ytmytm/ESPsette/kicad/production/bom.csv

Designator | Footprint | Quantity | Value | LCSC Part #
BUT_RESET1 | SW_PUSH_6mm | 1 | BUT_RESET
C1 | CP_Radial_D8.0mm_P3.50mm | 1 | 100µF
C6, C7 | CP_EIA-3216-12_Kemet-S_HandSolder | 2 | 10µ | C1969735
J1 | C64-Cassette-Port-Female | 1 | C64_TAPE_PORT
J2 | Mini_DIN_round_7_canned | 1 | Mini-DIN-7
J3 | PinHeader_1x06_P2.54mm_Vertical | 1 | UART
J4 | PinHeader_1x03_P2.54mm_Vertical | 1 | AMS1117
J5 | PinHeader_1x02_P2.54mm_Vertical | 1 | EXT.POWER
JP1, JP2, JP3, JP4, JP5 | SolderJumper-2_P1.3mm_Bridged_RoundedPad1.0x1.5mm | 5 | Jumper_2_Bridged
JP_FLASH1 | PinHeader_1x02_P2.54mm_Vertical | 1 | JP_FLASH
R1 | R_Axial_DIN0207_L6.3mm_D2.5mm_P7.62mm_Horizontal | 1 | 470R
R2, R3, R4, R5 | R_Axial_DIN0207_L6.3mm_D2.5mm_P7.62mm_Horizontal | 4 | 10K
R6 | R_Axial_DIN0207_L6.3mm_D2.5mm_P7.62mm_Horizontal | 1 | 1K
U1 | ESP-01 | 1 | ESP-01v090
U2 | DIP-6_W7.62mm | 1 | 4N35
U3 | SOT-223-3_TabPin2 | 1 | AMS1117-3.3 | C6186
