ytmytm/ESPsette/experiments/fastloader/BOOTSTRAP.md

# Standard-ROM bootstrap and autostart

Three stages take an ordinary ROM `LOAD` through to PRG execution. Native
sources are in `native/fastloader/`; `make native` builds both targets with ACME.

| Component | C64 | C16 / Plus/4 |
| --- | --- | --- |
| Autostart vector, standard data block | `$0302..$0303` | `$0302..$0303` |
| Code inside standard header tail | `$0351`, 163 B | `$0348`, 157 B |
| Full receiver | `$0400`, 482 B; send 512 B | `$0800`, 610 B; send 768 B |
| Final ROM handoff trampoline | `$033C` | `$0333` |
| Firmware PRG address range | `$0801..$CFFF` | `$1001..$FCFF` |

The combined C16/Plus4 profile targets C16 with 64 KB RAM and Plus/4.
Programs through `$FCFF` are supported; writes beneath TED BASIC/KERNAL ROM
reach RAM without changing the mapping, as on C64. `$FD00` starts I/O.
Small programs remain usable on a stock 16 KB C16.
C64 writes beneath BASIC ROM reach RAM without changing the memory mapping;
the receiver keeps ROM/I/O visible and stops before `$D000`. A program that
needs to read that RAM later must select its own memory mapping. Payloads
overlapping the loader or reaching I/O are not supported.

## Standard tape stage

`PrgEncoder::beginAutostart()` generates a type-3 absolute header for a two-byte
load at `$0302`. The vector targets code in the unused header tail, after the
filename. C64 has 16 filename bytes and 171 code bytes. TED stores the type
byte separately at `$F8` and prints 17 filename bytes (ROM `$E9F3..$E9FD`,
Y=4..20 inclusive). Its seventeenth display byte is padded with a space;
code begins at tape offset 22 / RAM `$0348`, with 170 bytes available.
Putting code at offset 21 / `$0347` would print its first opcode as a stray
character after the name.

The production encoder generates both copies, parity and checksums, using its
ordinary pilot lengths. Two hundred short tail pulses allow the ROM to finish
the second data copy. The vector bytes are independent of the streamed PRG;
the PRG ring remains retained at offset 2 until the GPIO payload stage.

C64 starts with `SEI`, `LDA #$27`, `STA $00`, making WRITE input after seven
CPU cycles. TED first writes zero to the port latch and sets DDR `$0B`:
P1 must stay output low to release the external inverting 7406 sink. Setting
P1 to input leaves that driver sinking the physical line. Physical WRITE
returns through P6, shared with IEC CLK. The bootstrap then blanks the screen;
C64 additionally disables sprites and CIA interrupt sources.

## Mode selection

The stub temporarily makes WRITE an output and sends the physical word `$CA65`,
MSB first, sampled by ESP on each MOTOR-on transition. Each MOTOR-off interval
exceeds 1 ms even at fast TED NTSC speed. An additional MOTOR-on interval
separates bits. The external 7406 output inversion is accounted for in the stub.

The ESP keeps WRITE input throughout selection. Upon the `110` signature
prefix, its MOTOR ISR stops the I2S transmitter and switches READ high to GPIO,
well before the stub clears stale FLAG events. DMA allocation cleanup occurs
later in loop, not in the ISR. This prevents queued standard pulses or the idle
level from creating a false first fast strobe. The complete `$CA65` word arms
the receiver download. The final MOTOR-on is not itself a block request.

Immediately after the final signature bit, the computer releases WRITE again,
without the usual final MOTOR-on delay, and requests the first receiver page
by changing MOTOR. ESP starts driving data only after that request and its
settling delay. C64 keeps WRITE input throughout both downloads; TED keeps P1 output low
and reads physical WRITE on P6.
The full bootstrap receiver never repeats the cold monitor test's WRITE-output
initialization.

## Receiver download

The small stub uses simple MSB-first pairs: b7:b6, b5:b4, b3:b2, b1:b0.
It requests whole 256-byte pages with no descriptor; address and page count
are assembled into the stub. Default hold and byte pause are both 80 µs;
setup and pair gap are each 3 µs. All are configurable in the ESP settings.
After the last page, the sender changes to the optimized descriptor/payload
protocol in [README.md](README.md).

C64 uses screen RAM for the full receiver. TED uses color RAM: `$0400` contains
executable BASIC helpers and system state which must survive for RUN. The
receiver normalizes MOTOR to on before requesting its descriptor with off;
the sender ignores that normalization edge after the last bootstrap page.
A request arriving during the final pair hold remains pending.

## Payload and handoff

The descriptor contains destination, length and entry as little-endian words.
The optimized receiver reads up to 256 bytes per MOTOR transition. It owns
`$F7..$FF` and the stack. Pair assembly is inline, Y indexes the destination
and counts bytes, and only page rollover increments the pointer high byte.

Once the payload is stored, the receiver copies a small handoff trampoline
into the now-unused tape buffer. It restores ports/timers, KERNAL and BASIC
vectors, initializes the screen, restores program bounds, clears cassette
status and keyboard input, and launches the program. Screen initialization
may overwrite the receiver without overwriting the trampoline. Entry zero
selects BASIC CLR/RUN; any other entry selects JMP with IRQs enabled.
The ESP releases WRITE/SENSE after the final data hold before ROM resumes.

The harness exports ordinary periods and a TAP for stage one. That TAP alone
cannot load the PRG: the complete sender must recognize the signature and
supply the two fast stages. TED's ordinary pulses begin LOW, with LOW/HIGH
halves belonging to the same period. Starting at the other phase would pair
adjacent pulse lengths and prevent the ROM from recognizing the header.

## Reproducing the complete load

```sh
python3 experiments/fastloader/run-bootstrap-vice.py --machine all
python3 experiments/fastloader/run-bootstrap-vice.py --machine all --ntsc --mode machine
python3 experiments/fastloader/run-bootstrap-matrix.py
```

Monitor commands only type LOAD and observe execution/memory. ROM device-1
traps are disabled. Tests compare every downloaded receiver/payload byte and
confirm BASIC POKE or machine-code marker execution after ROM restoration.
The regression matrix covers three machines, both video standards, both launch
paths, block/page boundaries, unaligned destinations, maximum RAM payloads and
both C64 CIA variants. The ESP GPIO implementation and configurable delays also
have host wire-order tests. C64 PAL fastloading was confirmed on real hardware
on 2026-11-04; the user confirmed C16 hardware operation on 2026-11-11.
Remaining hardware variants still need testing.

There is no payload CRC or automatic retransmission. STOP releases the ESP
outputs; reset the computer before retrying an interrupted receiver. The
current ROM entry points target stock C64 BASIC and TED BASIC 3.5.

## C16 electrical regression (2026-11-11)

The local LittleSixteen schematic/netlist (`datasette.sch`, revision 4git,
2024-08-11) shows cassette WRITE through FB17 and R29 (100 ohms) into P6,
also the IEC CLK input. P1 controls IEC CLK through the inverting open-collector
U9 7406. READ goes to P4; MOTOR uses P3 through U9/Q5. With default JP12 1-2,
SENSE goes to the `$FD10` bit-2 path; JP12 2-3 reroutes it to P7 and is not the
loader's supported configuration. A 6510 conversion with permanently enabled
MOTOR is also outside this protocol, which requires MOTOR block requests.

The previous VICE model injected WRITE directly into P1 and omitted the
7406 sink, allowing a loader that could not work on this wiring to pass.
The isolated patch now combines physical WRITE, the IEC CLK level and the
computer's sink at P6. Against that model the old bootstrap detects CA65 but
fails to download the receiver; the corrected bootstrap and payload receiver
both read P6 and release the sink using P1 output low. The payload receiver
uses the final READ poll's BIT overflow flag to sample P6 without an extra
port read; the timing analyzer covers the slower WRITE-high branch.

The user confirmed that the corrected C16 fastloader works on real hardware
on 2026-11-11. VICE regression results: 33/33 complete bootstrap checks and
39/39 transport checks, including expected failures with unsafe timings.

## TED filename and 64 KB range regression

The ROM display test now stops after the FOUND filename loop and compares all
17 displayed bytes, including the trailing space. PAL/NTSC long-name cases and
maximum payloads through `$FCFF` pass for both BASIC RUN and machine-code
handoff. The expanded bootstrap matrix passes 38/38 checks.

Original local Aardvark (12,287 payload bytes, SYS 9458), Acidball (25,557 bytes,
SYS 4114) and AFL_Boulderdash (31,518 bytes, SYS 4128) each pass cold C16/64-KB
PAL ROM loading, full receiver/payload comparison and the BASIC SYS breakpoint.
Boulderdash's payload ends at `$8B1F` exclusive, exercising RAM beneath ROM.
Local game binaries are not included in the repository.

The user confirmed the filename and larger-PRG fixes work on hardware on
2026-11-11.
