ytmytm/ESPsette/kicad/plots/espsette.pdf

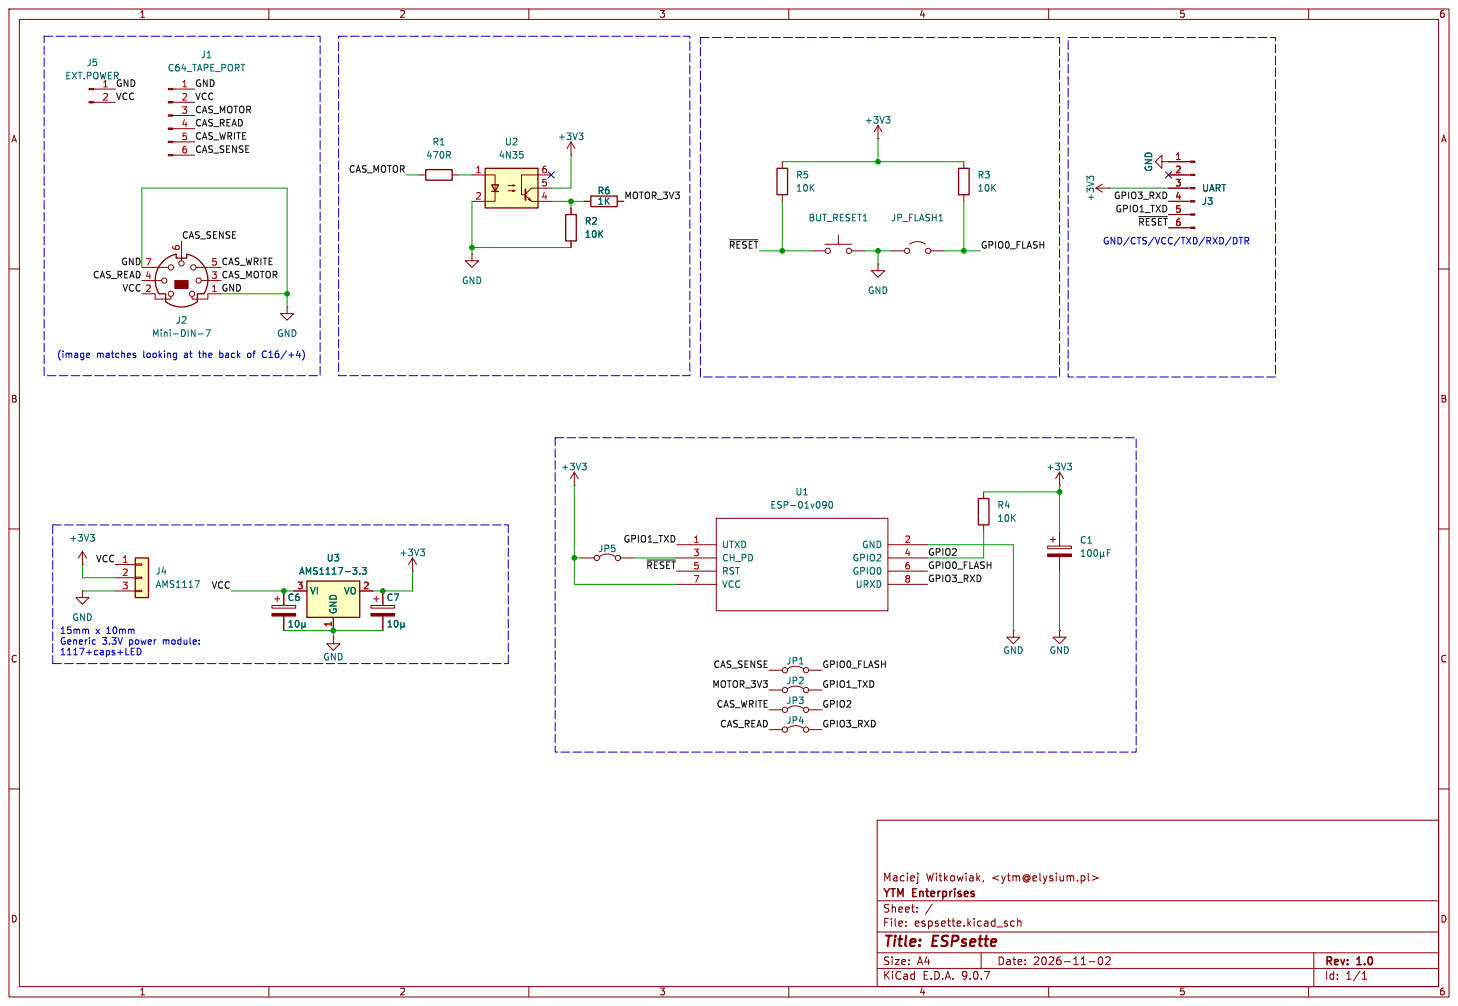
[picture p4: page 1]

þÿ10µ GND GND
Generic 3.3V power module: 1117+caps+LED
