ytmytm/ESPsette/(list of files, drawings)

Other design files:
kicad/espsette.dsn
