ytmytm/ESPsette/kicad/espsette.kicad_pcb

## KiCad design kicad/espsette.kicad_pcb (2026-11-11)

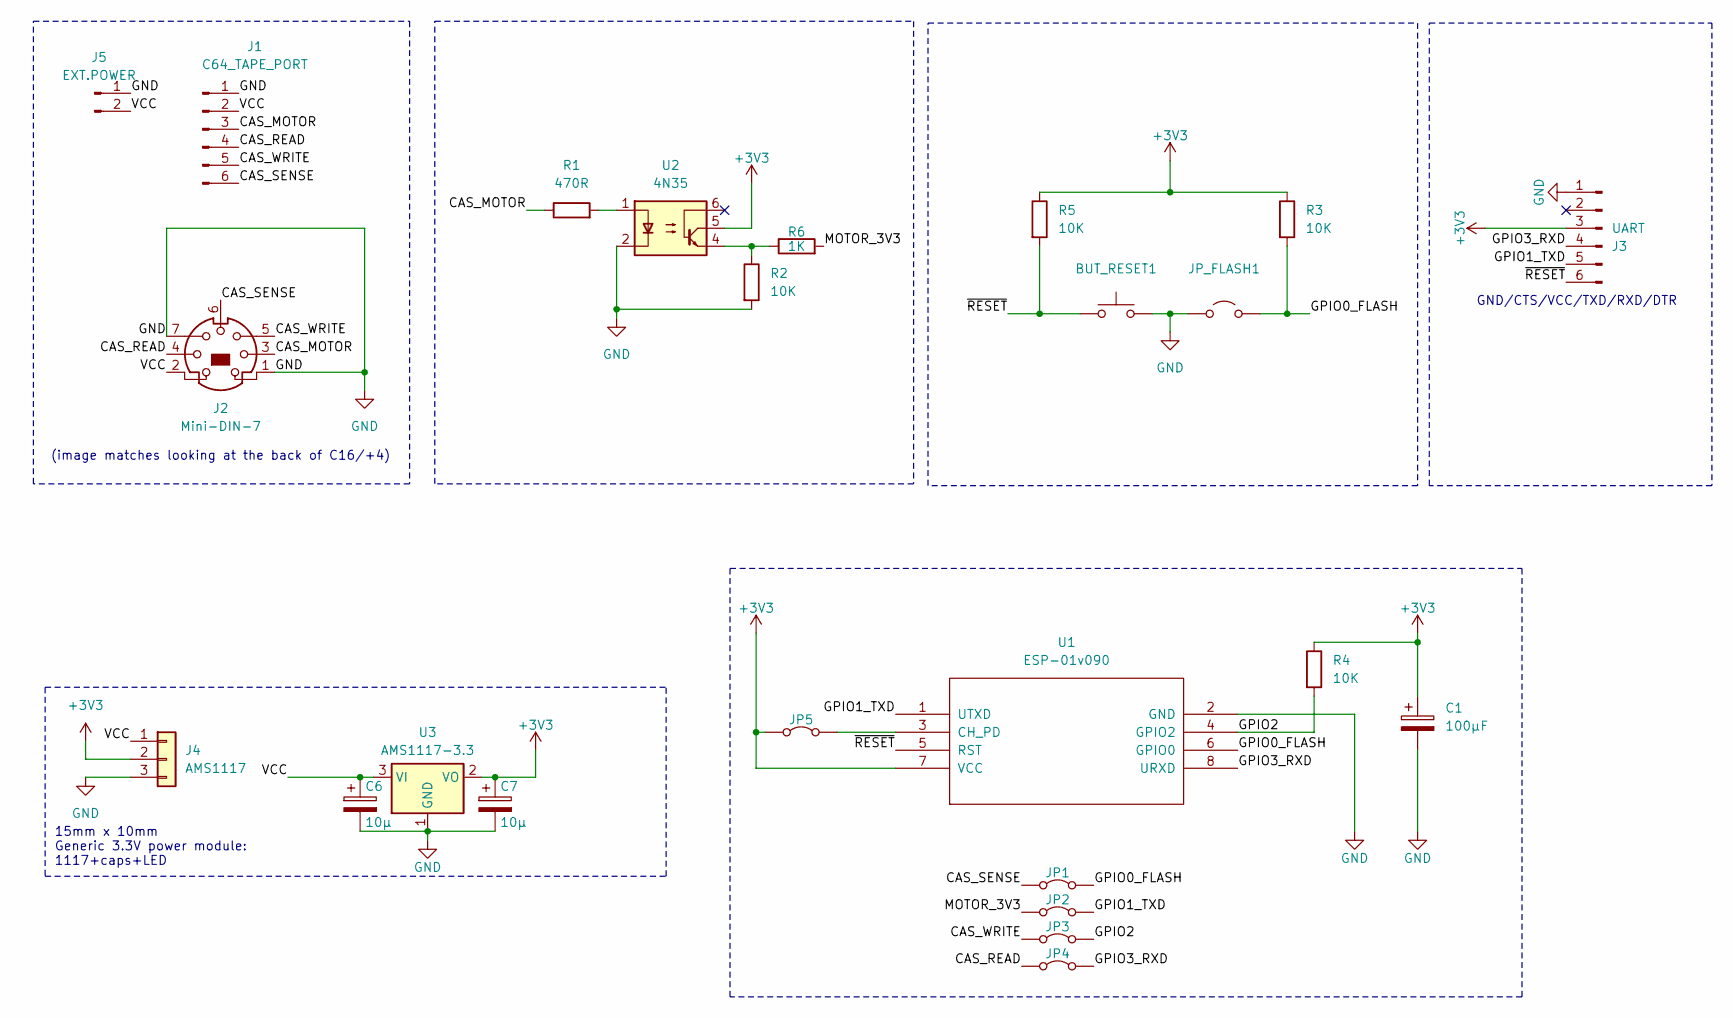
[picture p5: schematic espsette.kicad_sch]

Parts:
BUT_RESET1: BUT_RESET; SW_PUSH_6mm
C1: 100µF; CP_Radial_D8.0mm_P3.50mm
C6, C7: 10µ; CP_EIA-3216-12_Kemet-S_HandSolder; JLCPCB Part # C1969735
J1: C64_TAPE_PORT; C64-Cassette-Port-Female
J2: Mini-DIN-7; Mini_DIN_round_7_canned
J3: UART; PinHeader_1x06_P2.54mm_Vertical
J4: AMS1117; PinHeader_1x03_P2.54mm_Vertical
J5: EXT.POWER; PinHeader_1x02_P2.54mm_Vertical
JP1, JP2, JP3, JP4, JP5: Jumper_2_Bridged; SolderJumper-2_P1.3mm_Bridged_RoundedPad1.0x1.5mm
JP_FLASH1: JP_FLASH; PinHeader_1x02_P2.54mm_Vertical
R1: 470R; R_Axial_DIN0207_L6.3mm_D2.5mm_P7.62mm_Horizontal
R2, R3, R4, R5: 10K; R_Axial_DIN0207_L6.3mm_D2.5mm_P7.62mm_Horizontal
R6: 1K; R_Axial_DIN0207_L6.3mm_D2.5mm_P7.62mm_Horizontal
U1: ESP-01v090; ESP-01
U2: 4N35; DIP-6_W7.62mm
U3: AMS1117-3.3; SOT-223-3_TabPin2; JLCPCB Part # C6186

Connections:
+3V3: C1.1, C7.1, J3.3, J4.2, JP5.2 (B), R3.1, R4.1, R5.1, U1.7 (VCC), U2.5, U3.2 (VO)
/CAS_MOTOR: J1.3, J2.3, R1.1
/CAS_READ: J1.4, J2.4, JP4.2 (B)
/CAS_SENSE: J1.6, J2.6, JP1.2 (B)
/CAS_WRITE: J1.5, J2.5, JP3.2 (B)
/GPIO0_FLASH: JP1.1 (A), JP_FLASH1.2 (B), R3.2, U1.6 (GPIO0)
/GPIO1_TXD: J3.5, JP2.1 (A), U1.1 (UTXD)
/GPIO2: JP3.1 (A), R4.2, U1.4 (GPIO2)
/GPIO3_RXD: J3.4, JP4.1 (A), U1.8 (URXD)
/MOTOR_3V3: JP2.2 (B), R6.2
/VCC: C6.1, J1.2, J2.2, J4.1, J5.2, U3.3 (VI)
/~RESET: BUT_RESET1.1, J3.6, R5.2, U1.5 (RST)
GND: BUT_RESET1.2, C1.2, C6.2, C7.2, J1.1, J2.1, J2.7, J3.1, J4.3, J5.1, JP_FLASH1.1 (A), R2.2, U1.2 (GND), U2.2, U3.1 (GND)
unnamed: JP5.1 (A), U1.3 (CH_PD)
unnamed: R1.2, U2.1
unnamed: R2.1, R6.1, U2.4

Notes on the sheet:
GND/CTS/VCC/TXD/RXD/DTR
(image matches looking at the back of C16/+4)
15mm x 10mm Generic 3.3V power module: 1117+caps+LED

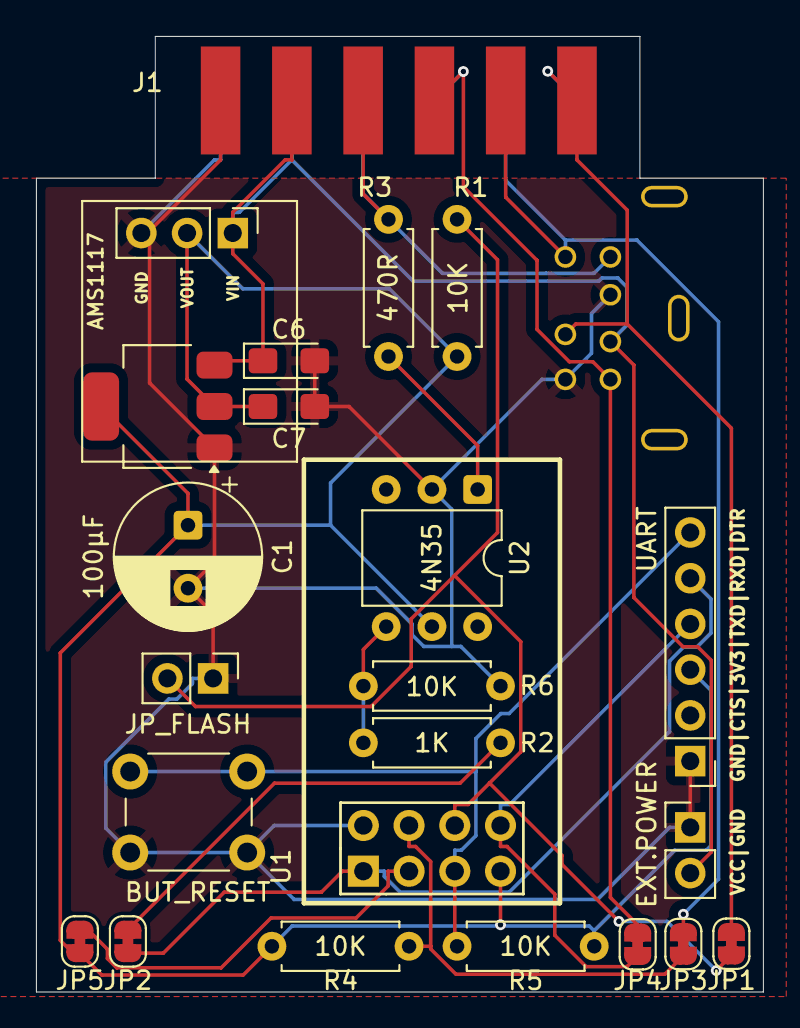
[picture p6: board espsette.kicad_pcb from above]

Board: 2 copper layers, 40.4 x 53.1 mm, 24 parts (0 on the bottom side), 16 nets.
