ytmytm/ESPsette/src/tape_source.cpp

#include "tape_source.h"

#include <pgmspace.h>
#include <string.h>

namespace {
uint8_t flashByte(const uint8_t* address) {
  return pgm_read_byte(address);
}
}  // namespace

void TapeSource::useEmbedded(const uint8_t* data, uint32_t size) {
  kind_ = Kind::EMBEDDED;
  embedded_ = data;
  embeddedRepeat_ = 0;
  prefixSize_ = 20;
  size_ = size;
  retainedFrom_ = 20;
  nextOffset_ = size;
  sessionId_ = 0;
}

bool TapeSource::useEmbeddedPrg(const uint8_t* data, uint32_t size, bool repeat) {
  if (!data || size < 3 || size > 65537) return false;
  useEmbedded(data, size);
  prefixSize_ = 2;
  retainedFrom_ = 2;
  if (repeat) {
    embeddedRepeat_ = size - 2;
    size_ += embeddedRepeat_;
    nextOffset_ = size_;
  }
  return true;
}

void TapeSource::useStream(const uint8_t header[20], uint32_t size, uint32_t id) {
  kind_ = Kind::STREAMED;
  embedded_ = nullptr;
  embeddedRepeat_ = 0;
  prefixSize_ = 20;
  memcpy(header_, header, sizeof(header_));
  size_ = size;
  retainedFrom_ = 20;
  nextOffset_ = 20;
  sessionId_ = id;
}

void TapeSource::usePrg(const uint8_t loadAddress[2], uint32_t logicalSize, uint32_t id) {
  kind_ = Kind::STREAMED;
  embedded_ = nullptr;
  embeddedRepeat_ = 0;
  prefixSize_ = 2;
  memcpy(header_, loadAddress, 2);
  size_ = logicalSize;
  retainedFrom_ = 2;
  nextOffset_ = 2;
  sessionId_ = id;
}

bool TapeSource::seek(uint32_t offset, uint32_t newId) {
  if (kind_ != Kind::STREAMED || offset < prefixSize_ || offset >= size_ || newId == 0) return false;
  retainedFrom_ = offset;
  nextOffset_ = offset;
  sessionId_ = newId;
  return true;
}

void TapeSource::eject() {
  kind_ = Kind::EMPTY;
  embedded_ = nullptr;
  embeddedRepeat_ = 0;
  prefixSize_ = 20;
  size_ = 0;
  retainedFrom_ = 20;
  nextOffset_ = 20;
  sessionId_ = 0;
}

bool TapeSource::read(uint32_t offset, uint8_t& value) const {
  if (offset >= size_) return false;
  if (kind_ == Kind::EMBEDDED) {
    if (embeddedRepeat_ && offset >= embeddedRepeat_ + 2) offset -= embeddedRepeat_;
    value = flashByte(embedded_ + offset);
    return true;
  }
  if (kind_ != Kind::STREAMED) return false;
  if (offset < prefixSize_) {
    value = header_[offset];
    return true;
  }
  if (offset < retainedFrom_ || offset >= nextOffset_) return false;
  value = buffer_[offset % BUFFER_SIZE];
  return true;
}

uint16_t TapeSource::bufferedBytes() const {
  return kind_ == Kind::STREAMED ? nextOffset_ - retainedFrom_ : 0;
}

uint16_t TapeSource::freeBytes() const {
  return kind_ == Kind::STREAMED ? BUFFER_SIZE - bufferedBytes() : 0;
}

bool TapeSource::append(uint32_t offset, const uint8_t* data, size_t length) {
  if (kind_ != Kind::STREAMED || offset != nextOffset_ ||
      length > freeBytes() || length > size_ - nextOffset_) return false;
  for (size_t i = 0; i < length; ++i) buffer_[(nextOffset_ + i) % BUFFER_SIZE] = data[i];
  nextOffset_ += length;
  return true;
}

void TapeSource::releaseBefore(uint32_t offset) {
  if (kind_ != Kind::STREAMED) return;
  if (offset > nextOffset_) offset = nextOffset_;
  if (offset > retainedFrom_) retainedFrom_ = offset;
}
