ytmytm/ESPsette/src/write_decoder.h

#pragma once

#include <stddef.h>
#include <stdint.h>

#if defined(ESP8266)
#include <Arduino.h>
#define WRITE_IRAM IRAM_ATTR
#else
#define WRITE_IRAM
#endif

// C64/C16 standard WRITE-header command channel. File data is discarded.
// A verified ESP:<request> publishes a request; command handlers are not installed.
// feedEdgeMicros() accepts same-polarity periods from the direct WRITE pin.
// A pilot selects C64 rising or TED falling edges before byte decoding.
class WriteDecoder {
 public:
  enum class Machine : uint8_t { UNKNOWN, C64, C16 };
  void WRITE_IRAM motorStart(uint32_t quietMicros = UINT32_MAX);
  void WRITE_IRAM motorStop();
  void WRITE_IRAM suspend();
  void WRITE_IRAM feedMicros(uint16_t duration);
  void WRITE_IRAM feedEdgeMicros(uint16_t duration, bool high);
  void WRITE_IRAM overflow();
  Machine machine() const { return machine_; }
  const char* status() const { return status_; }
  const char* name() const { return name_; }
  const char* command() const { return command_; }
  uint32_t commandCount() const { return commandCount_; }
  const char* machineName() const {
    return machine_ == Machine::C64 ? "c64" : machine_ == Machine::C16 ? "c16" : "unknown";
  }
  uint8_t fileType() const { return header_[0]; }
  uint16_t startAddress() const { return header_[1] | (uint16_t(header_[2]) << 8); }
  uint16_t endAddress() const { return header_[3] | (uint16_t(header_[4]) << 8); }
  uint32_t receivedCount() const { return receivedCount_; }
  uint32_t errorCount() const { return errorCount_; }
  uint32_t overflowCount() const { return overflowCount_; }

 private:
  enum class Pulse : uint8_t { INVALID, SHORT, MEDIUM, LONG };
  enum class Stage : uint8_t {
    SEARCH, FIRST_SYNC, FIRST_HEADER, FIRST_CHECKSUM, FIRST_END,
    SECOND_SYNC, SECOND_HEADER, SECOND_CHECKSUM, DISCARD, DONE
  };
  static constexpr uint16_t HEADER_BYTES = 192;
  Pulse firstPulse_ = Pulse::INVALID;
  bool byteBits_ = false;
  bool ambiguousEnd_ = false;
  uint8_t bitIndex_ = 0;
  uint8_t byte_ = 0;
  uint8_t parity_ = 1;
  Stage stage_ = Stage::SEARCH;
  Machine machine_ = Machine::UNKNOWN;
  uint8_t c64Pilot_ = 0, tedPilot_ = 0;
  uint32_t discardBytes_ = 0;
  uint8_t expectedSync_ = 0;
  uint16_t headerIndex_ = 0;
  uint8_t checksum_ = 0;
  uint8_t header_[HEADER_BYTES] = {};
  char name_[17] = {};
  char command_[13] = {};
  uint32_t commandCount_ = 0;
  bool suspended_ = false;
  const char* status_ = "idle";
  uint32_t receivedCount_ = 0;
  uint32_t errorCount_ = 0;
  uint32_t overflowCount_ = 0;

  Pulse WRITE_IRAM classify(uint16_t duration) const;
  void WRITE_IRAM resetFrame();
  void WRITE_IRAM fail(const char* reason);
  void WRITE_IRAM onByte(uint8_t value);
  void WRITE_IRAM onTerminator();
  void WRITE_IRAM finishHeader();
};
