ytmytm/ESPsette/(commit log)

2026-10-22 Add KiCad project and output directories
2026-10-22 Document hardware activity LEDs
2026-10-23 Keep PlatformIO state local for NFS and add VERBOSE builds.
    flock fails on the share; route core/cache/workspace under ~/.cache and print progress before pio starts.
2026-10-23 Disable RemoteDebug WebSockets for ESP8266 Arduino 3.x.
    Bundled WebSockets calls removed BearSSL verify(); Telnet debug is enough, with a small patch as a safety net.
2026-10-23 Fix web handler prototypes and IRAM interrupt attrs.
    PlatformIO needs forward decls for handleRoot/handleNotFound; replace deprecated ICACHE_RAM_ATTR.
2026-10-23 Treat firmware as a normal C++ translation unit.
    Add Arduino.h so PlatformIO skips .ino preprocessing after the rename.
    [main.cpp]
2026-10-24 Document CH340 DTR-to-RST flash wiring and esptool reset.
    Verified GPIO0-GND plus DTR-RST on a wemos.cc adapter; esptool.cfg pulses DTR only.
    [esptool.cfg]
2026-10-24 Add make help listing build and serial flash targets.
    Default make goal so bare make shows usage and CH340 wiring notes.
2026-10-24 Add a small UART dump helper for ESP8266 ROM boot messages.
    Pulse DTR like esptool.cfg hard reset and capture 74880 baud output for reboot-loop checks on USB-serial.
    [esp_boot_dump.py]
2026-10-24 Document repeated PRG data requirement for streaming encoder
2026-10-24 Add failure vectors, session recovery, and runtime diagnostics
    [main.cpp, write_decoder_test.cpp]
2026-10-24 Replace deprecated ICACHE_RAM_ATTR with IRAM_ATTR.
    Carry the bootstrap interrupt-attr cleanup onto the rebased implementation tree.
    [main.cpp]
2026-10-24 Add forward declarations for HTTP handlers in main.cpp.
    PlatformIO no longer auto-prototypes after the .ino to .cpp rename.
    [main.cpp]
2026-10-24 Add ESPSETTE_GPIO_DISABLED bench mode for Wi-Fi-only bring-up.
    Keep tape MOTOR/SENSE/READ off the pins by default so USB-serial bench can run AP and the web UI without remapping UART or driving cassette GPIOs.
2026-10-24 Restore flash wiring docs and add cassette pin table.
    Bring back the CH340 DTR–RST ESP-01 flash guide lost in the implementation rebase, and document MOTOR/SENSE/READ/WRITE GPIO mapping next to the soft-GPIO bench note.
2026-10-25 Defer PROGMEM demo insert so Wi-Fi survives boot and /demo.
    Walk the embedded TAP only from loop via pgm_read_byte, and poll /state until load finishes instead of blocking the HTTP handler.
2026-10-25 Replace the custom Wi-Fi portal with WiFiManager captive setup.
    Match ESPHome-style AP provisioning, wipe legacy LittleFS config once, and re-enter setup via /wifi.
    [network_config.cpp, network_config.h]
2026-10-25 Add soft playback, READ scope, and server FF for GPIO-disabled bench.
    Treat motor as running without I2S so the deck and counter animate, expose a downsampled READ waveform, allow /nav seeks on embedded TAP, and scroll to the deck after Demo tape.
2026-10-25 Require PLAY with motor for tape run; polish deck and IDX nav.
    Gate soft/real playback on MOTOR+PLAY, lock reel positions, show demo ROM buffer and remaining time, and make REW/FF follow IDX markers or tape ends.
2026-10-25 Enable open OTA and document the 1m64 flash trade-off.
    Use a 64KB LittleFS layout so ArduinoOTA fits on 1MB; keep TAP streaming from the browser because there is no room for a LittleFS tape cache. /wifi only forgets Wi-Fi after confirm.
2026-10-25 Disable OTA while the embedded demo keeps the 1MB image oversized.
    ArduinoOTA needs a second copy of the sketch; with draxcaught in PROGMEM that fails with Not Enough Space, so ESPSETTE_OTA=0 and updates stay on serial flash.
    [main.cpp]
2026-10-25 Document boot-safe 4N35 MOTOR wiring for the KiCad netlist.
    Capture the open-collector pin4/pin5 swap with pull-up so GPIO0 stays high at C64-powered cold start, and note that SENSE/autoplay cannot fix that boot strap.
2026-10-25 Fix soft TAP underrun by releasing the stream ring, and show C64/C16.
    GPIO-disabled playback never freed consumed bytes, so the 8 KB buffer stalled after one fill; also surface the TAP header machine on the deck.
    [main.cpp, tape_source_ring_test.cpp]
2026-10-25 Enable real cassette GPIOs in the default 1MB build.
    Switch ESPSETTE_GPIO_DISABLED off for hardware LOAD testing; soft-GPIO remains available via the build flag.
2026-11-01 Clarify build, serial flash wiring and hardware test status
2026-11-01 Document both tape connector options and ignore local TODO
2026-11-01 Record complete C64 tape connector CAD reference
2026-11-01 Document PCB edge contacts as a tape connector fallback
2026-11-01 Specify ESP-01 power, reset and in-circuit programming hardware
2026-11-01 Plan alternative module and SMD regulator assembly from TCBM2SD
2026-11-01 Match CH340G programmer header order and clarify UART crossover
2026-11-01 Link CH340 driver resources in flashing instructions
2026-11-01 Map C16 mini-DIN tape pins from Pi1551-HAT connector J4
2026-11-02 Add ESPsette KiCad design, manufacturing files and PCB previews
    [espsette-B_Cu.gbl, espsette-B_Mask.gbs, espsette-B_Paste.gbp, espsette-B_Silkscreen.gbo, espsette-Edge_Cuts.gm1, espsette-F_Cu.gtl, espsette-F_Mask.gts, espsette-F_Paste.gtp]
2026-11-03 Avoid flash writes for unchanged default computer settings
    [main.cpp]
2026-11-03 Correct ESPsette branding and add the project link to the deck
    [render-deck-brand.py]
2026-11-04 Make STOP spring back while playback remains stopped
2026-11-04 Make fastloader reels visibly faster from the start of the fast stage
2026-11-04 Save the fastloader switch immediately and keep timing edits independent
2026-11-04 Collapse advanced fastloader timings and their action buttons
2026-11-04 Remove redundant fastloader switch explanation
2026-11-04 Fix direct WRITE SAVE reception using real VICE ROM traces
    [main.cpp, patch-vice.py, replay.cpp, run-vice.py, test_write_vice.py, vice-device.c, write_decoder.cpp, write_decoder.h]
2026-11-04 Decode WRITE in IRAM independently of HTTP and expose reset diagnostics
    [main.cpp, pio-native.py, replay.cpp, write_decoder.cpp, write_decoder.h]
2026-11-05 Replace embedded TAP demo with Circles PRG without enabling OTA
    [build-demo.py, embed-demo.py, embedded_demo_test.cpp, main.cpp, pio-native.py, run-bootstrap-vice.py, run-vice.py]
2026-11-06 Keep TAP playback fed across HTTP waits and MOTOR pauses
    Refill DMA cooperatively, preserve partial source records, and separate 500 ms full state polls from compact transfer updates. Retain the browser File on invalid responses and ESP playback failures, with timing and request diagnostics.
    Validated with 19 host tests, browser regressions, the 1 MB build, full Rambo replay and C64 PAL hardware confirmation. OTA stays disabled; WRITE requires EJECT.
    [main.cpp, test_tap_dma.py]
2026-11-06 Increase streaming resilience with a 12 KB buffer and awake Wi-Fi
    Reuse live upload acknowledgements, keep full-state polling out of PLAY, and reduce standard polling to 250 ms. Add VFD Wi-Fi signal display and remove temporary request timing history. Document hardware validation and cover buffer wrapping and uncertain upload replies.
    [main.cpp, tape_source.h, tape_source_ring_test.cpp, test_tap_dma.py]
2026-11-07 added power connector in case USB-Serial can't provide enough current for flashing, moved parts around
    [bom.csv, designators.csv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]
2026-11-09 Swap MOTOR and SENSE GPIOs for modified ESP-01 board
    [main.cpp]
2026-11-11 Fix C16 fastloader WRITE wiring and filename color
    [analyze-timing.py, build-native.py, prg_encoder.cpp, prg_vectors_test.cpp, receiver.asm, run-bootstrap-vice.py, vice-device.c]
2026-11-11 Fix TED filename padding and support 64 KB fast PRGs
    [fastloader_prg.h, fastloader_wire_test.cpp, main.cpp, make-bootstrap.cpp, prg_encoder.cpp, prg_encoder.h, prg_vectors_test.cpp, run-bootstrap-matrix.py]
2026-11-11 Update KiCad board with tape isolation jumpers and GPIO remapping
    [bom.csv, designators.csv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]
